UTSM-proto/utsm-telem-firmware/lte_relay/README.md

# QUICK START: LIVE TELEMETRY

From the `utsm-telem-firmware` repository folder, run this one command:

```powershell
.\start_live_telem.cmd
```

The setup page opens automatically. Connect only the WROVER by USB, select its
COM port, and click **Program WROVER and start telemetry**. The launcher handles
the dashboard, permanent Cloudflare route, private key, firmware build, upload,
and redirect to the live telemetry page. Running the command again
automatically replaces the previous idle UTSM dashboard process.

The public dashboard is `https://telem.utsm.party/live`. The Cloudflared
Windows service starts at boot with the same hostname. The dashboard also has
an at-sign-in startup task, so restarting the computer or externally powered
WROVER does not change the firmware endpoint and does not require reflashing.

# T-A7670X LTE relay

This sketch receives the existing telemetry record over ESP-NOW and posts it
to the software dashboard over LTE. SD logging on the ESP32-C3 remains the
complete source of truth; this relay intentionally has no persistent buffer.

The same WROVER also accepts the dyno joulemeter C3's distinct ESP-NOW packet
on channel 1. It maintains one newest-packet slot per source and alternates
between ready car and dyno data, so a slow LTE POST cannot make one sender
overwrite the other sender's newest measurement.

## Hardware

- LILYGO T-A7670E/G/SA ESP32-WROVER-E board
- ESP32-C3 SuperMini on the TelemV2 telemetry board
- second ESP32-C3 SuperMini running the dyno joulemeter firmware
- LTE main antenna attached before powering the modem
- Activated nano-SIM with data service
- Stable USB/5 V supply capable of modem current peaks (use at least 2 A)

The ESP-NOW hop is wireless. Do not connect UART wires between the logger and
relay. Power both boards normally and keep them within radio range.

### Dyno integration flash order

1. Deploy the matching telemetry dashboard change.
2. Copy `relay_config.example.h` to the ignored `relay_config.h`, keep the
   existing API key private, and set the dashboard `/api/live/telemetry` URL.
3. Flash `lte_relay.ino` to the WROVER/A7670 first. This reflash is required
   because the relay must recognize the new dyno packet type.
4. Keep the existing live-car C3 firmware running; it does not need a reflash
   for this change.
5. Flash `dyno_joulemeter_firmware.ino` from `UTSM-proto/proto-dyno` to the
   second C3.
6. Open the site, click **Start dyno test**, run the dyno, then click **Stop
   test** to freeze the Wh-to-Wh efficiency result.

Expected relay lines while both sources are active:

```text
Dashboard POST status=202
LIVE seq=12 delivered in ... ms json=... B
DYNO seq=18 delivered in ... ms P=84.215 W json=... B
```

Successful compilation does not validate ESP-NOW range, sensor calibration,
LTE timing, or simultaneous delivery on physical hardware.

The root preparation script now includes the dyno checkout and opens all three
Arduino sketches while retaining the existing dashboard, API-key, and
Cloudflare-tunnel setup:

```powershell
powershell -ExecutionPolicy Bypass -File .\prepare_live_motor_temp.ps1
```

For the single-entry setup portal, run this instead:

```powershell
.\start_live_telem.cmd
```

The command opens `http://127.0.0.1:8000/setup`. Connect only the WROVER,
select its COM port, and click **Program WROVER and start telemetry**. The page
creates or validates the Cloudflare tunnel, writes the matching private API key
and tunnel endpoint into the ignored relay configuration, compiles with the
Huge APP and PSRAM settings, uploads the relay, and redirects to `/live` after
a successful flash. The programming controls accept requests only through the
local `localhost` page; they are not available through the public tunnel.

When testing from alternate Git worktrees, pass their paths without moving or
stashing another checkout's changes:

```powershell
powershell -ExecutionPolicy Bypass -File .\prepare_live_motor_temp.ps1 `
  -SoftwareRepoPath "C:\path\to\telemetry-site-worktree" `
  -DynoRepoPath "C:\path\to\proto-dyno-worktree"
```

### Verified bench configuration

The complete path was bench-tested with:

- LILYGO T-A7670G R2 with `A7670G-LLSE` modem
- A7670 firmware `A7670M7_B02V01_251111`
- Lucky Mobile SIM
- Lucky Mobile APN `connect`, with blank username and password
- ESP32-C3 SuperMini transmitting ESP-NOW broadcast packets on channel 1
- FastAPI dashboard exposed temporarily through Cloudflare Tunnel

The modem registered on LTE, opened a packet-data session, received an IP,
and delivered matching C3 packet sequences to the dashboard.

### Physical setup

1. With power disconnected, attach the LTE antenna to the connector marked
   `SIM`/`LTE`; do not attach it to `GNSS` for the LTE test.
2. Disable the SIM PIN in a phone, power the board off, and insert the nano-SIM.
3. Power the A7670X through its USB-C port using a data-capable USB-A-to-USB-C
   cable and a source capable of 5 V/2 A peaks. This board can fail to power
   from USB-C-to-USB-C.
4. Power the C3 separately. No UART wiring is required between the boards.
5. Keep the two boards within a few metres for the bench test.

## Modem communication smoke test

Before installing LTE libraries or inserting a SIM, flash
`a7670_at_test/a7670_at_test.ino`. Open Serial Monitor at 115200 baud. The
automatic test should return `OK` for `AT` and print the exact modem identity
for `AT+SIMCOMATI`. The monitor then remains as a direct AT-command terminal.

## Arduino setup

Install:

- Espressif `esp32` board package
- LilyGO's bundled `TinyGSM` fork from the `lib` folder in
  [LilyGo-Modem-Series](https://github.com/Xinyuan-LilyGO/LilyGo-Modem-Series)

Select an ESP32 WROVER-compatible board and enable PSRAM if that board profile
offers the option.

Tested A7670X Arduino IDE settings:

- Board: `ESP32 Dev Module`
- CPU frequency: `240 MHz (WiFi/BT)`
- Flash frequency: `80 MHz`
- Flash mode: `QIO`
- Flash size: `4 MB`
- Partition scheme: `Huge APP (3MB No OTA/1MB SPIFFS)`
- PSRAM: enabled
- Serial Monitor: `115200` baud

For the C3 dummy sender, select `ESP32C3 Dev Module` and use a 115200-baud
Serial Monitor.

Copy `relay_config.example.h` to `relay_config.h`, then set the carrier APN,
the full dashboard ingestion URL, and the same API key used by the server.

Example Lucky Mobile configuration:

```cpp
static const char LTE_APN[] = "connect";
static const char LTE_USER[] = "";
static const char LTE_PASSWORD[] = "";
static const char SIM_PIN[] = "";
static const char TELEMETRY_ENDPOINT[] =
  "https://YOUR-TUNNEL.trycloudflare.com/api/live/telemetry";
static const char TELEMETRY_API_KEY[] = "replace-with-demo-key";
static const char TELEMETRY_DEVICE_ID[] = "utsm-a7670g";
```

For a first SIM test, disable the SIM PIN in a phone, confirm mobile data works,
then move the powered-off SIM into the T-A7670X. A normal phone SIM usually
works when the carrier permits modem/tethered data and the APN is correct.

## Start the dashboard and tunnel

From the software repository in PowerShell:

```powershell
python -m venv .venv
.venv\Scripts\Activate.ps1
python -m pip install -r requirements.txt
$env:UTSM_TELEMETRY_API_KEY = "replace-with-demo-key"
python -m uvicorn live_dashboard.app:app --host 0.0.0.0 --port 8000
```

Open `http://127.0.0.1:8000/live`. In a second PowerShell window:

```powershell
cloudflared tunnel --url http://localhost:8000
```

Put the generated HTTPS hostname plus `/api/live/telemetry` in
`TELEMETRY_ENDPOINT`. The API key must exactly match the environment variable.
Quick-tunnel hostnames change whenever the tunnel is restarted. The normal
UTSM workflow now uses the permanent `telem.utsm.party` tunnel instead.

## Prototype behavior

- Valid records are posted immediately.
- Records received while LTE is unavailable are dropped from the live stream.
- The original ESP32-C3 SD CSV is unaffected.
- The logger broadcasts at most once per second. If LTE is slower than the
  incoming stream, the relay keeps only the newest pending packet so the live
  page catches up instead of displaying an old FIFO backlog.
- The WROVER prints each LTE POST duration and JSON payload size. Use those
  values to measure the carrier/modem's real sustainable rate and watch data
  use against the vehicle SIM's 500 MB allowance; HTTP/TLS overhead is not
  included in the printed JSON byte count.
- SD still records at the full sensor sample rate. The TelemV2 logger uses the
  ADS1115's 860 SPS conversion mode while retaining 20-sample averaging and a
  separate open/write/close for every SD row.
- TelemV2 sends valid GPS latitude/longitude with the live packet. The map
  activates automatically after the GPS obtains a fix.
- TelemV2 sends beam-break `wheel_speed_kph` and its validity state. A valid
  stopped wheel is sent as `0.00`; an uninitialized sensor is sent as `null`.

## Level 2: LTE-only dummy test

This test uses only the T-A7670X and verifies SIM registration, LTE data,
HTTPS ingestion, WebSocket updates, gauges, charts, table, and map. The main
ESP32-C3 telemetry board is not required.

1. Copy `relay_config.example.h` to `relay_config.h`.
2. Set the carrier APN, public dashboard endpoint, and matching API key.
3. Set `LTE_DUMMY_TEST_MODE = true`.
4. Flash `lte_relay.ino` and open the serial monitor at 115200 baud.
5. Expect `Mode: LEVEL 2 LTE DUMMY TEST`, an assigned LTE IP, HTTP status 202,
   repeating `DUMMY seq=N delivered` messages, and changing speed on the live
   dashboard.
6. Return `LTE_DUMMY_TEST_MODE` to `false` before the ESP-NOW integration test.

## Level 3: full-path ESP-NOW dummy test

This proves `ESP32-C3 telemetry board -> ESP-NOW -> A7670X relay -> LTE -> dashboard`
without requiring live sensors.

1. Set `LTE_DUMMY_TEST_MODE = false` in the relay's ignored `relay_config.h`.
2. Flash `lte_relay/lte_relay.ino` to the T-A7670X and leave it powered.
3. Flash `telem-v1/espnow_dummy_sender/espnow_dummy_sender.ino` to the ESP32-C3
   SuperMini.
4. Open both serial monitors at 115200 if two USB ports are available.
5. The C3 prints `C3 ESP-NOW queued seq=N`; the relay prints
   `LIVE seq=N delivered`; the dashboard updates with the same sequence.

Expected relay output:

```text
Mode: LIVE ESP-NOW RELAY
Relay ESP-NOW channel: 1
LTE connected; IP: ...
Dashboard POST status=202
LIVE seq=0 delivered
```

Expected C3 output:

```text
C3 ESP-NOW channel: 1
C3 dummy sender ready; transmitting every 2 seconds
C3 ESP-NOW queued seq=0 I=11000 mA V=49560 mV
```

Both boards are explicitly pinned to ESP-NOW channel 1 for this demo.

### If the relay prints status 715

`Dashboard POST status=715` is an A7670 TLS-handshake failure. It is not, by
itself, evidence that the SIM is out of data. If the preceding lines show LTE
registration, a normal CSQ value, and an assigned IP address, the packet-data
session is up. Check whether the tunnel's current TLS certificate and cipher
support are compatible with the modem firmware. A successful vehicle-path test
still requires status 202, `LIVE seq=... delivered`, and a fresh dashboard row.

## Level 4: TelemV2 live vehicle demo

This is the real end-to-end path:
`TelemV2 -> ESP-NOW -> WROVER/A7670 -> LTE -> HTTPS -> live dashboard`.

On the UTSM Windows workstation, the root-level preparation script automates
the local setup: Arduino dependencies, LilyGO's A7670-compatible TinyGSM fork,
dashboard startup, Cloudflare quick tunnel, ignored relay endpoint update, and
opening both Arduino sketches. Run it from PowerShell:

```powershell
powershell -ExecutionPolicy Bypass -File .\prepare_live_motor_temp.ps1
```

After it reports `PREPARATION COMPLETE`, the only manual operations are the two
Arduino IDE uploads: flash `lte_relay.ino` to the WROVER/A7670 first, then flash
`telemetry_v2.ino` to the ESP32-C3. The script never prints the telemetry API
key. Re-running it reuses a healthy tunnel and existing configured credentials.

1. Start the dashboard with `UTSM_TELEMETRY_API_KEY` set and open `/live`.
2. Start a Cloudflare quick tunnel and copy its current HTTPS hostname.
3. In the ignored `relay_config.h`, set `TELEMETRY_ENDPOINT` to that hostname
   followed by `/api/live/telemetry`, use the same API key as the server, and
   ensure `LTE_DUMMY_TEST_MODE = false`.
4. Flash `lte_relay/lte_relay.ino` to the WROVER/A7670 board.
5. Flash `telem-v2/telemetry_v2/telemetry_v2.ino` to the ESP32-C3 logger.
6. Attach the LTE and GPS antennas, insert the SIM, power both boards, and
   leave the laptop running the dashboard and tunnel.
7. Wait through TelemV2 initialization. Its LED becomes solid when SD logging
   starts. Outdoors, wait for the live page map to receive a GPS position.
8. The page targets a new row about once per second. Actual rate is capped by
   the measured LTE POST duration printed by the relay. Move the car outdoors
   and the GPS marker/trail should move with the vehicle.

The relay's serial success line is `LIVE seq=N delivered`, but serial access is
not required in the vehicle: increasing sequence numbers on `/live` prove the
complete path. If rows update without a map marker, LTE is working but the GPS
does not yet have a valid fix.

When only the WROVER Serial Monitor is accessible, each real packet also shows:

```text
GPS seq=12 rx=GPIO20 baud=9600 bytes=1842 nmea=yes sats=7 utc=yes fix=yes
```

- `bytes=0`: the C3 has received no electrical UART data at the displayed pin/rate.
- Increasing `bytes` with `nmea=no`: bytes exist, but no checksum-valid NMEA sentence has been decoded yet.
- `rx=GPIO21` or `rx=GPIO20` and `baud=...`: the candidate currently being tested or locked.
- `nmea=yes sats=0`: the module is communicating but has not acquired satellites.
- `sats>0 fix=no`: keep the antenna stationary with a clear view of the sky.
- `fix=yes`: the next LTE post includes latitude/longitude for the live map.

If the C3 prints `queued` but the relay prints nothing, confirm both serial
monitors report ESP-NOW channel 1. If the relay reports HTTP 401, the dashboard
and relay API keys differ. HTTP 404 usually means the endpoint is missing
`/api/live/telemetry`.
