UTSM-proto/utsm-telem-firmware/telem-v2/pcb/telem-v2-pcb/joulemeter.kicad_pcb

## KiCad design telem-v2/pcb/telem-v2-pcb/joulemeter.kicad_pcb (2026-07-04)

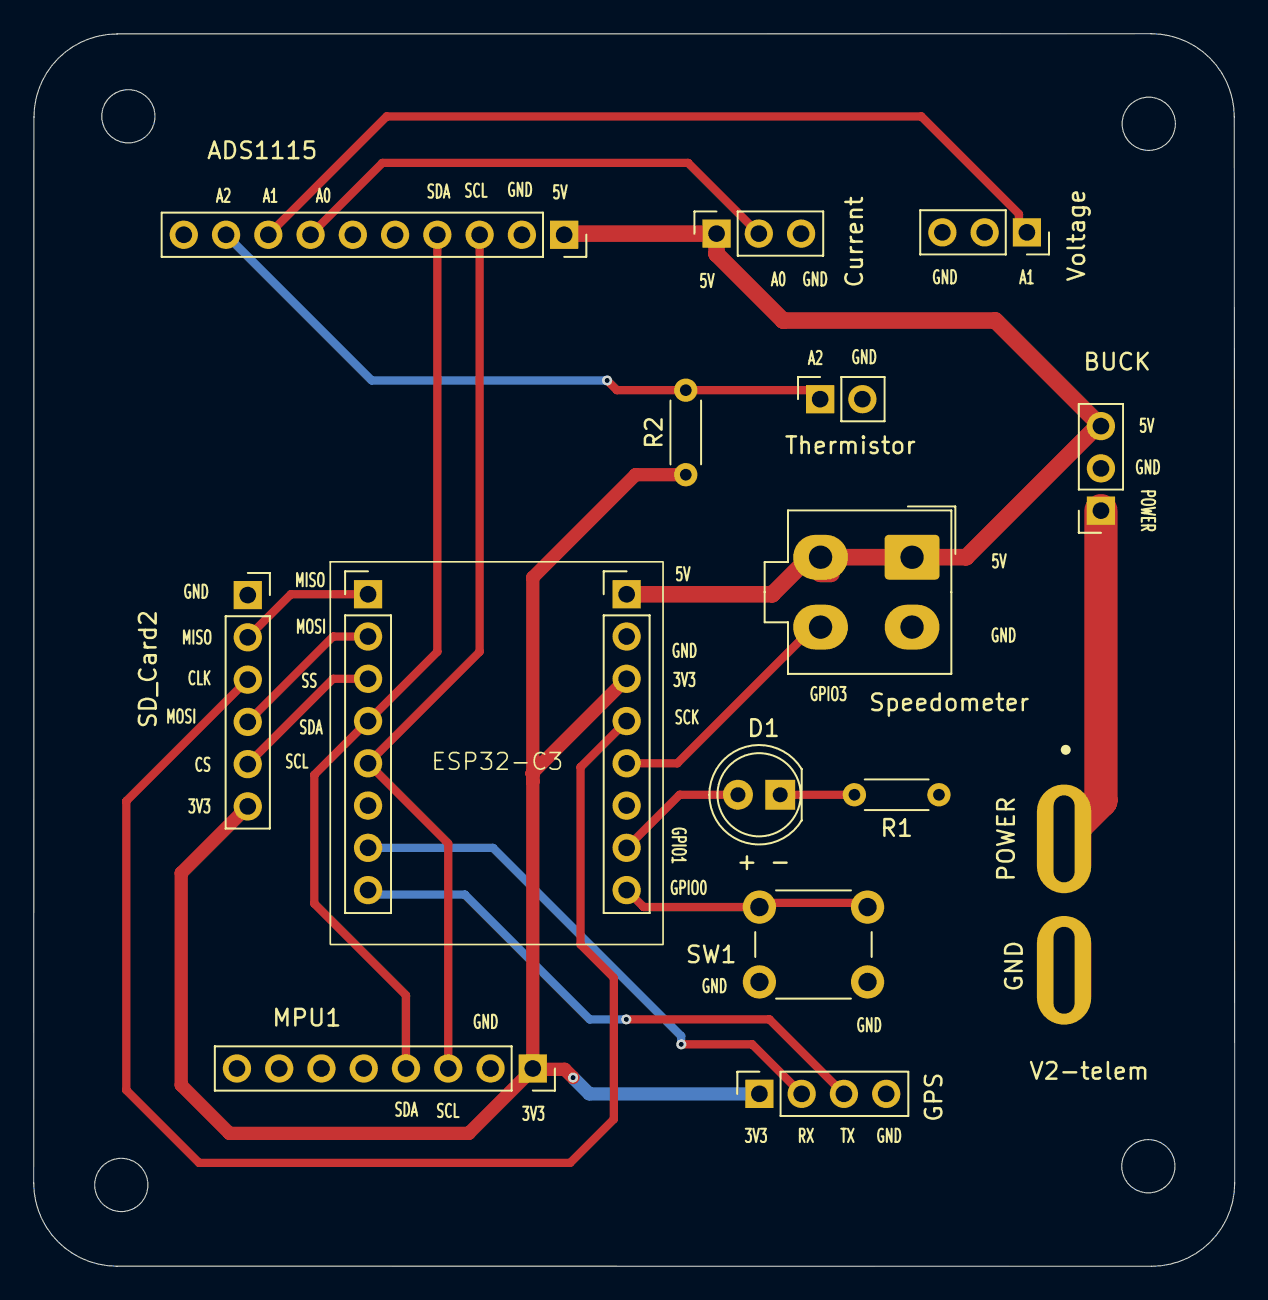
[picture p1: board telem-v2/pcb/telem-v2-pcb/joulemeter.kicad_pcb from above]

Board: 2 copper layers, 72.2 x 74.1 mm, 15 parts (0 on the bottom side), 19 nets.

Parts:
ADS1115: Conn_01x10_Pin; PinSocket_1x10_P2.54mm_Vertical
BuckConverter1: Conn_01x03_Pin; PinSocket_1x03_P2.54mm_Vertical
Current: Conn_01x03_Pin; PinSocket_1x03_P2.54mm_Vertical
D1: LED; LED_D5.0mm
ESP32-C3: C3; ESP32C3
GPS: Conn_01x04_Pin; PinSocket_1x04_P2.54mm_Vertical
J1: ASMPR45-1X2-RK; APP_ASMPR45-1X2-RK
J2: Speedometer; Molex_Mini-Fit_Jr_5566-04A_2x02_P4.20mm_Vertical
MPU1: Conn_01x8_Pin; PinSocket_1x08_P2.54mm_Vertical
R1: R; R_Axial_DIN0204_L3.6mm_D1.6mm_P5.08mm_Horizontal
R2: 33k; R_Axial_DIN0204_L3.6mm_D1.6mm_P5.08mm_Horizontal
SD_Card2: Conn_01x6_Pin; PinSocket_1x06_P2.54mm_Vertical
SW1: SW_Push; SW_PUSH_6mm_H5mm
TH1: Thermistor; PinSocket_1x02_P2.54mm_Vertical
Voltage: Conn_01x03_Pin; PinSocket_1x03_P2.54mm_Vertical

Connections:
3.3V: ESP32-C3.13 (3.3V), GPS.1 (VCC), MPU1.1 (VCC), R2.1, SD_Card2.6 (3.3V)
+5V: ADS1115.1 (VDD), BuckConverter1.3 (VCC), Current.1 (VCC), ESP32-C3.11 (5V), J2.1, J2.3
External_Power: BuckConverter1.1 (External_Power), J1.1
GND: ADS1115.2 (GND), BuckConverter1.2 (GND), Current.3 (GND), ESP32-C3.12 (GND), GPS.4 (GND), J1.2, J2.2, MPU1.2 (GND), R1.2, SD_Card2.1 (GND), SW1.2, TH1.2, Voltage.3 (-)
MISO: ESP32-C3.5 (5-MISO), SD_Card2.2 (MISO)
MOSI: ESP32-C3.6 (6-MOSI), SD_Card2.4 (MOSI)
unnamed: ADS1115.7 (A0), Current.2 (OUT)
unnamed: ADS1115.8 (A1), Voltage.1 (S)
unnamed: ADS1115.9 (A2), R2.2, TH1.1
unnamed: D1.2 (A), ESP32-C3.1 (GPIO1)
unnamed: D1.1 (K), R1.1
unnamed: ESP32-C3.7 (7-SS), SD_Card2.5 (CS)
unnamed: ESP32-C3.0 (GPIO0), SW1.1
unnamed: ESP32-C3.3 (GPIO3), J2.4
RX: ESP32-C3.20 (20-RX), GPS.2 (RX)
SCK: ESP32-C3.4 (GPIO4-SCK), SD_Card2.3 (CLK)
SCL: ADS1115.3 (SCL), ESP32-C3.9 (9-SCL), MPU1.3 (SCL)
SDA: ADS1115.4 (SDA), ESP32-C3.8 (8-SDA), MPU1.4 (SDA)
TX: ESP32-C3.21 (21-TX), GPS.3 (TX)
