UTSM-proto/utsm-telem-firmware/telem-v1/pcb/telem-v1-pcb/joulemeter.kicad_pcb

## KiCad design telem-v1/pcb/telem-v1-pcb/joulemeter.kicad_pcb (2026-06-18, an earlier design)

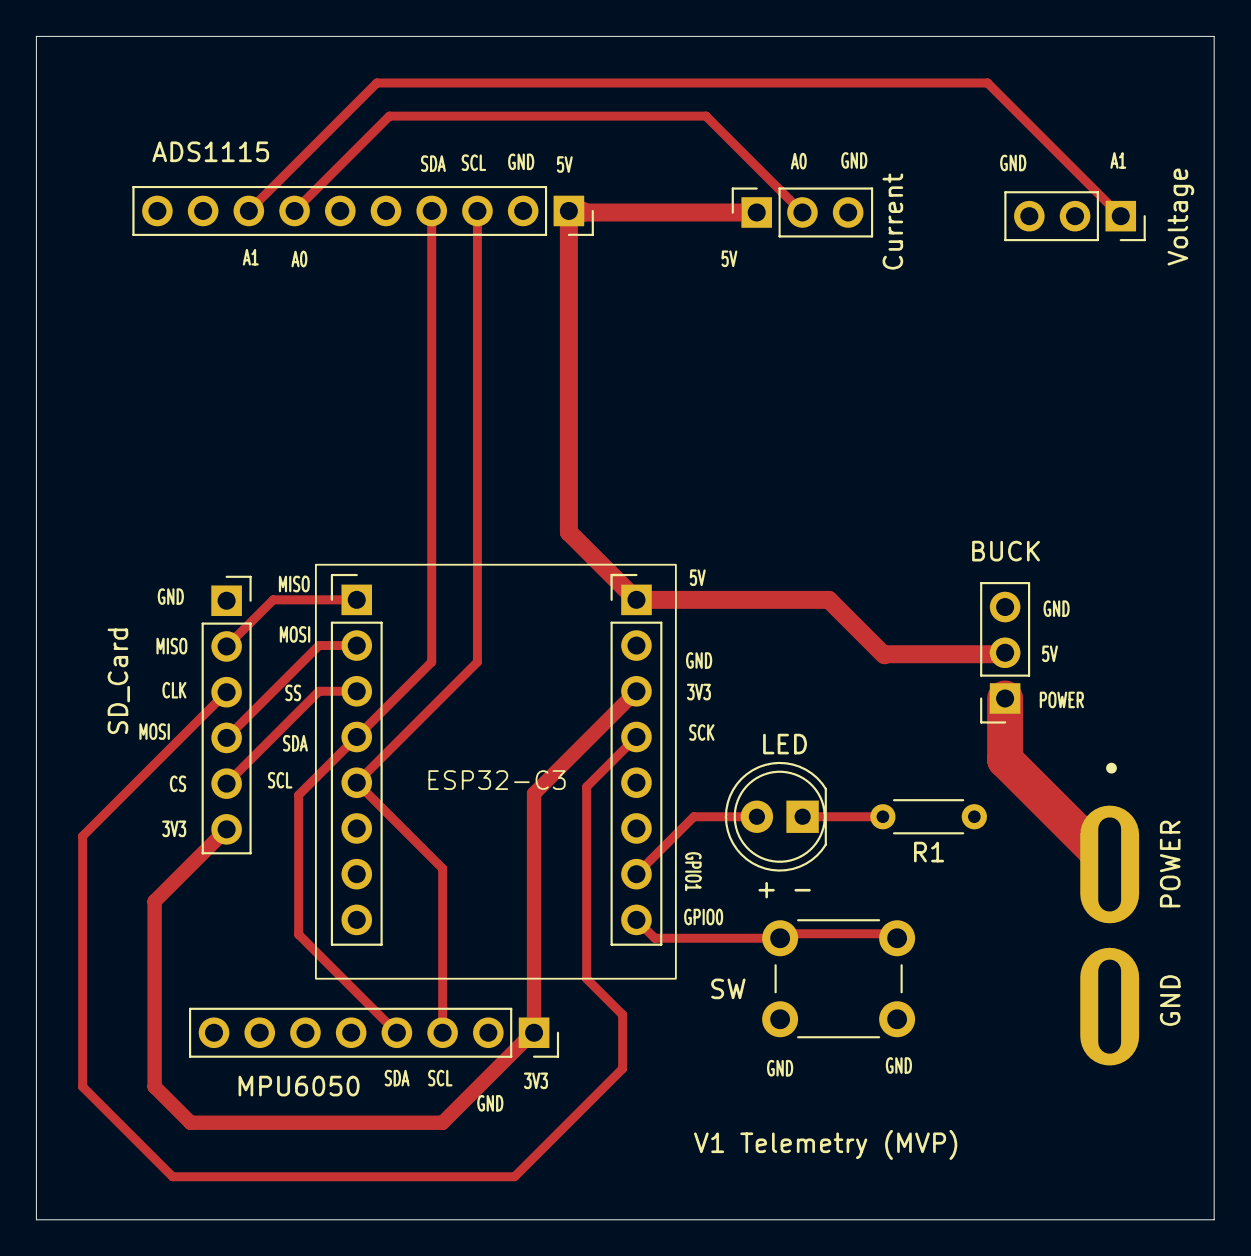
[picture p2: board telem-v1/pcb/telem-v1-pcb/joulemeter.kicad_pcb from above]

Board: 2 copper layers, 65.4 x 65.7 mm, 11 parts (0 on the bottom side), 15 nets.

Parts:
ADS1115: Conn_01x10_Pin; PinSocket_1x10_P2.54mm_Vertical
BuckConverter: Conn_01x03_Pin; PinSocket_1x03_P2.54mm_Vertical
Current: Conn_01x03_Pin; PinSocket_1x03_P2.54mm_Vertical
ESP32-C3: C3; ESP32C3
J1: ASMPR45-1X2-RK; APP_ASMPR45-1X2-RK
LED: LED; LED_D5.0mm
MPU6050: Conn_01x8_Pin; PinSocket_1x08_P2.54mm_Vertical
R1: R; R_Axial_DIN0204_L3.6mm_D1.6mm_P5.08mm_Horizontal
SD_Card: Conn_01x6_Pin; PinSocket_1x06_P2.54mm_Vertical
SW: SW_Push; SW_PUSH_6mm_H5mm
Voltage: Conn_01x03_Pin; PinSocket_1x03_P2.54mm_Vertical

Connections:
3.3V: ESP32-C3.13 (3.3V), MPU6050.1 (VCC), SD_Card.6 (3.3V)
+5V: ADS1115.1 (VDD), BuckConverter.2 (VCC), Current.1 (VCC), ESP32-C3.11 (5V)
External_Power: BuckConverter.1 (External_Power), J1.1
GND: ADS1115.2 (GND), BuckConverter.3 (GND), Current.3 (GND), ESP32-C3.12 (GND), J1.2, MPU6050.2 (GND), R1.2, SD_Card.1 (GND), SW.2, Voltage.3 (-)
MISO: ESP32-C3.5 (5-MISO), SD_Card.2 (MISO)
MOSI: ESP32-C3.6 (6-MOSI), SD_Card.4 (MOSI)
unnamed: ADS1115.7 (A0), Current.2 (OUT)
unnamed: ADS1115.8 (A1), Voltage.1 (S)
unnamed: ESP32-C3.1 (GPIO1), LED.2 (A)
unnamed: LED.1 (K), R1.1
unnamed: ESP32-C3.7 (7-SS), SD_Card.5 (CS)
unnamed: ESP32-C3.0 (GPIO0), SW.1
SCK: ESP32-C3.4 (GPIO4-SCK), SD_Card.3 (CLK)
SCL: ADS1115.3 (SCL), ESP32-C3.9 (9-SCL), MPU6050.3 (SCL)
SDA: ADS1115.4 (SDA), ESP32-C3.8 (8-SDA), MPU6050.4 (SDA)
