UTSM-proto/utsm-telem-firmware/telem-v2/telemetry_v2/telemetry_v2.ino

/*
  ESP32-C3 Vehicle Telemetry Logger
  ---------------------------------
  Arduino setup/dependencies:
    - Board target: ESP32C3 Dev Module (esp32:esp32:esp32c3)
    - Install "esp32 by Espressif Systems" in Boards Manager
    - Install "TinyGPSPlus by Mikal Hart" in Library Manager
    - Wire, LittleFS, FS, SD, and SPI are included with the ESP32 board core
    - WiFi and ESP-NOW are included with the ESP32 board core

  Collects:
    - Current from ADS1115 AIN0
    - Voltage from ADS1115 AIN1
    - Thermistor temperature from ADS1115 AIN2
    - Acceleration from MPU6050
    - Wheel speed from a beam-break sensor and 12 wheel spokes
    - GPS position, speed, altitude, HDOP, satellites, and UTC time
  Writes each recording session to an SD-card CSV.
  Mirrors current, voltage, acceleration, and GPS every 1 second over ESP-NOW
  to the vehicle's WROVER/A7670 LTE relay. Live forwarding never blocks SD.

  CSV filenames are derived directly from GPS UTC time:
      /YYYY-MM-DD-HH-MM.csv
  If that name already exists:
      /YYYY-MM-DD-HH-MM-001.csv
  If GPS time is unavailable after the startup wait:
      /telemetry_001.csv

  Status LED:
    - Repeating flashes with a long pause indicate a fatal fault. Count the
      flashes and see telem-v2/telemetry_v2/README.md.
    - Solid ON means recording. OFF means manually stopped.

  Pin mapping (ESP32-C3 Super Mini):
    I2C SDA       GPIO8
    I2C SCL       GPIO9
    Start/stop    GPIO0, active LOW
    Status LED    GPIO1
    Speedometer   GPIO3 (LM393 digital output)
    SD SCK        GPIO4
    SD MISO       GPIO5
    SD MOSI       GPIO6
    SD CS         GPIO7
    GPS RX        GPIO20 (connected to GPS module TX)
    GPS TX        unused (GPS module RX is connected to GPIO21)
*/

#include <Arduino.h>
#include <Wire.h>
#include <LittleFS.h>
#include <math.h>
#include <TinyGPS++.h>

#include "FS.h"
#include "SD.h"
#include "SPI.h"
#include "live_telemetry_espnow.h"

// =========================
// Pin mapping
// =========================
static const int PIN_I2C_SDA = 8;
static const int PIN_I2C_SCL = 9;
static const int BUTTON_PIN  = 0;
static const int LED_PIN     = 1;
static const int SPEED_SENSOR_PIN = 3;

static const int SD_CS   = 7;
static const int SD_MOSI = 6;
static const int SD_MISO = 5;
static const int SD_SCK  = 4;

// Confirmed vehicle wiring: GPS module TX is connected to C3 GPIO20 and GPS
// module RX is connected to C3 GPIO21. The logger only receives, so GPIO20 is
// the primary UART RX candidate and GPIO21 is retained as a diagnostic fallback.
static const int GPS_PRIMARY_RX_PIN = 20;
static const int GPS_ALTERNATE_RX_PIN = 21;
static const uint32_t GPS_BAUD = 9600;
static const uint32_t GPS_UART_PROBE_MS = 3000;

// The logger never sends configuration commands to the GPS, so UART TX is
// intentionally left disconnected. This lets detection listen on either PCB
// trace without ever driving against the GPS module's TX output.
static const int GPS_UART_TX_UNUSED = -1;

struct GpsUartCandidate {
  int rxPin;
  uint32_t baud;
};

static const GpsUartCandidate GPS_UART_CANDIDATES[] = {
  {GPS_PRIMARY_RX_PIN, 9600},
  {GPS_ALTERNATE_RX_PIN, 9600},
  {GPS_PRIMARY_RX_PIN, 38400},
  {GPS_ALTERNATE_RX_PIN, 38400},
  {GPS_PRIMARY_RX_PIN, 115200},
  {GPS_ALTERNATE_RX_PIN, 115200},
  {GPS_PRIMARY_RX_PIN, 4800},
  {GPS_ALTERNATE_RX_PIN, 4800},
};
static const size_t GPS_UART_CANDIDATE_COUNT =
  sizeof(GPS_UART_CANDIDATES) / sizeof(GPS_UART_CANDIDATES[0]);

// =========================
// Beam-break speedometer
// =========================
// The LM393 output is LOW while a spoke blocks the beam and HIGH while the
// beam is clear. A small high-priority task debounces both states and counts
// exactly one completed blocked-to-clear cycle per spoke. This prevents
// comparator flicker at either spoke border from becoming extra wheel pulses.
// The module used by the dyno has its own output pull-up, so GPIO3 is a plain
// input.
static const uint8_t WHEEL_SPOKES = 12;
static const float WHEEL_DIAMETER_M = 20.0f * 0.0254f;
static const float WHEEL_CIRCUMFERENCE_M = PI * WHEEL_DIAMETER_M;
static const uint32_t SPEED_SAMPLE_PERIOD_MS = 1;
static const uint32_t SPEED_STATE_DEBOUNCE_US = 2000;
// Real spoke events are about 12 ms apart at the vehicle's 40 km/h maximum.
// An 8 ms guard rejects impossible repeats while retaining margin to 60 km/h.
static const uint32_t SPEED_MIN_PULSE_INTERVAL_US = 8000;
static const uint32_t SPEED_STOP_TIMEOUT_US = 2000000;

portMUX_TYPE g_speedMux = portMUX_INITIALIZER_UNLOCKED;
volatile bool g_speedHasPulse = false;
volatile uint32_t g_speedLastPulseUs = 0;
volatile uint32_t g_speedIntervalSumUs = 0;
volatile uint16_t g_speedIntervalCount = 0;
volatile uint32_t g_speedSpokeCount = 0;

bool g_wheelSpeedValid = false;
float g_wheelSpeedKmph = 0.0f;
float g_wheelRpm = 0.0f;
uint32_t g_wheelSpokeCount = 0;

// =========================
// Device addresses
// =========================
static const uint8_t ADS1115_ADDR = 0x48;
static const uint8_t MPU6050_ADDR = 0x68;

// =========================
// Sampling constants
// =========================
#define CURRENT_NUM_SAMPLES  20

#define MPU_NUM_SAMPLES      20
#define MPU_SAMPLE_DELAY     3

// GPS is serviced during all long waits so its UART buffer does not overflow.
static const uint32_t GPS_FILENAME_WAIT_MS = 30000;
static const uint32_t GPS_DIAGNOSTIC_INTERVAL_MS = 1000;

// =========================
// ADS1115 registers/config
// =========================
#define ADS1115_REG_CONVERSION      0x00
#define ADS1115_REG_CONFIG          0x01

#define ADS1115_CONFIG_OS_SINGLE    0x8000
#define ADS1115_CONFIG_MUX_AIN0_GND 0x4000
#define ADS1115_CONFIG_MUX_AIN1_GND 0x5000
#define ADS1115_CONFIG_MUX_AIN2_GND 0x6000
#define ADS1115_CONFIG_PGA_4V096    0x0200
#define ADS1115_CONFIG_MODE_SINGLE  0x0100
#define ADS1115_CONFIG_DR_860SPS    0x00E0
#define ADS1115_CONFIG_COMP_DISABLE 0x0003

// At 860 samples/second a single conversion takes about 1.2 ms. Waiting 2 ms
// retains margin without the old fixed 10 ms delay on every channel read.
static const uint32_t ADS1115_CONVERSION_WAIT_MS = 2;

#define ADS1115_CONFIG_WORD_AIN0 (ADS1115_CONFIG_OS_SINGLE     | \
                                  ADS1115_CONFIG_MUX_AIN0_GND  | \
                                  ADS1115_CONFIG_PGA_4V096     | \
                                  ADS1115_CONFIG_MODE_SINGLE   | \
                                  ADS1115_CONFIG_DR_860SPS     | \
                                  ADS1115_CONFIG_COMP_DISABLE)

#define ADS1115_CONFIG_WORD_AIN1 (ADS1115_CONFIG_OS_SINGLE     | \
                                  ADS1115_CONFIG_MUX_AIN1_GND  | \
                                  ADS1115_CONFIG_PGA_4V096     | \
                                  ADS1115_CONFIG_MODE_SINGLE   | \
                                  ADS1115_CONFIG_DR_860SPS     | \
                                  ADS1115_CONFIG_COMP_DISABLE)

#define ADS1115_CONFIG_WORD_AIN2 (ADS1115_CONFIG_OS_SINGLE     | \
                                  ADS1115_CONFIG_MUX_AIN2_GND  | \
                                  ADS1115_CONFIG_PGA_4V096     | \
                                  ADS1115_CONFIG_MODE_SINGLE   | \
                                  ADS1115_CONFIG_DR_860SPS     | \
                                  ADS1115_CONFIG_COMP_DISABLE)

static const float ADS1115_LSB_VOLTS = 4.096f / 32768.0f;

// =========================
// Current/voltage calibration
// =========================
static const float ADC_DIVIDER_RATIO   = 1.0f;
static const float ADC_ZERO_CURRENT_V  = 2.55f;
static const float ADC_SENSITIVITY     = 0.066f;
static const float VOLTAGE_INPUT_SCALE = 5.93f;
// Bench fit: I_actual = 0.7949 * I_measured - 0.70904 A.
// Startup zeroing is performed after this fit so resting current remains 0 A.
static const float CURRENT_CAL_SLOPE     = 0.7949f;
static const float CURRENT_CAL_INTERCEPT = -0.70904f;

static const uint32_t CURRENT_ZERO_CAL_DELAY_MS = 15000;
static const uint32_t CURRENT_ZERO_CAL_TIME_MS  = 3000;
float g_currentOffsetA = 0.0f;

// =========================
// Thermistor calibration
// =========================
// Divider:
//   3.28 V -- 33.5k resistor -- AIN2 -- thermistor -- GND
static const float THERMISTOR_SUPPLY_V          = 3.28f;
static const float THERMISTOR_SERIES_R_OHMS     = 33500.0f;
static const float THERMISTOR_NOMINAL_R_OHMS    = 95000.0f;
static const float THERMISTOR_NOMINAL_TEMP_C    = 23.5f;
static const float THERMISTOR_B_COEFFICIENT     = 3950.0f;

// Ground AIN2 and use serial command 'c' to measure this offset.
// Copy the reported value here if a permanent correction is required.
static const float THERMISTOR_ADC_OFFSET_V = 0.0f;
float g_thermistorAdcOffsetV = THERMISTOR_ADC_OFFSET_V;
static const uint16_t THERMISTOR_OFFSET_CAL_SAMPLES = 64;

// =========================
// MPU6050 registers/config
// =========================
#define MPU6050_REG_PWR_MGMT_1   0x6B
#define MPU6050_REG_ACCEL_CONFIG 0x1C
#define MPU6050_REG_ACCEL_XOUT_H 0x3B

#define MPU6050_ACCEL_SENS_2G 16384.0f
#define GRAVITY_MPS2          9.80665f

// =========================
// GPS
// =========================
TinyGPSPlus gps;
HardwareSerial gpsSerial(1);
int g_gpsRxPin = GPS_PRIMARY_RX_PIN;
uint32_t g_gpsBaud = GPS_BAUD;
size_t g_gpsUartCandidateIndex = 0;
bool g_gpsUartLocked = false;
uint32_t g_gpsUartProbeStartMs = 0;
uint32_t g_gpsUartByteCount = 0;
uint32_t g_gpsUartProbeStartByteCount = 0;
uint32_t g_gpsUartProbeStartPassedChecksum = 0;

// =========================
// Logging state
// =========================
static const uint16_t SD_MAX_LOG_FILES = 999;
char g_sdLogFile[48] = "/telemetry_unknown.csv";
uint16_t g_sdLogIndex = 0;

bool g_sdReady = false;
bool g_loggingEnabled = false;
LiveTelemetryEspNowSender g_liveTelemetry;

// The record layout includes wheel-speed fields, so use a new backup filename
// instead of interpreting older binary records with the new structure.
static const char *LITTLEFS_LOG_FILE = "/telemetry_v2_speed.bin";

volatile bool buttonEvent = false;
uint32_t lastButtonHandledMs = 0;
uint32_t lastGpsDiagnosticMs = 0;

// =========================
// Logged record
// =========================
struct TelemetryRecord_t
{
  uint32_t timestamp_ms;

  int16_t current_mA;
  int32_t voltage_mV;

  int16_t temperature_c_x100;
  uint8_t temperature_valid;

  uint8_t wheel_speed_valid;
  uint32_t wheel_speed_kmph_x100;
  uint32_t wheel_rpm_x10;
  uint32_t wheel_spoke_count;

  int16_t accel_x_mps2_x100;
  int16_t accel_y_mps2_x100;
  int16_t accel_z_mps2_x100;
  uint16_t accel_mag_mps2_x100;

  uint8_t gps_location_valid;
  int32_t gps_lat_e7;
  int32_t gps_long_e7;
  int32_t gps_alt_cm;
  uint16_t gps_speed_kmph_x100;
  uint16_t gps_hdop_x100;
  uint8_t gps_sats;

  uint8_t gps_time_valid;
  uint8_t gps_hour;
  uint8_t gps_minute;
  uint8_t gps_second;
  uint8_t gps_centisecond;
} __attribute__((packed));

// =========================
// Forward declarations
// =========================
void serviceGps();
void updateWheelSpeed();
void updateLoggingLed();
bool selectNextSDLogFile();
void startLoggingNewFile(const char *reason);

// =========================
// Interrupt
// =========================
void IRAM_ATTR buttonISR()
{
  buttonEvent = true;
}

void acceptSpeedPulse(uint32_t nowUs)
{
  portENTER_CRITICAL(&g_speedMux);

  if (!g_speedHasPulse) {
    g_speedHasPulse = true;
    g_speedLastPulseUs = nowUs;
    g_speedSpokeCount = g_speedSpokeCount + 1;
    portEXIT_CRITICAL(&g_speedMux);
    return;
  }

  uint32_t intervalUs = nowUs - g_speedLastPulseUs;

  // Reject repeats that imply a speed above the 60 km/h measurement margin.
  // Rejected events do not move the reference timestamp.
  if (intervalUs < SPEED_MIN_PULSE_INTERVAL_US) {
    portEXIT_CRITICAL(&g_speedMux);
    return;
  }

  g_speedLastPulseUs = nowUs;
  g_speedSpokeCount = g_speedSpokeCount + 1;

  // Do not turn a long stopped period into one misleading low-speed sample.
  // The next spoke interval will establish the restarted wheel speed.
  if (intervalUs >= SPEED_STOP_TIMEOUT_US) {
    portEXIT_CRITICAL(&g_speedMux);
    return;
  }

  if (UINT32_MAX - g_speedIntervalSumUs < intervalUs ||
      g_speedIntervalCount == UINT16_MAX) {
    g_speedIntervalSumUs = intervalUs;
    g_speedIntervalCount = 1;
  } else {
    g_speedIntervalSumUs += intervalUs;
    g_speedIntervalCount = g_speedIntervalCount + 1;
  }

  portEXIT_CRITICAL(&g_speedMux);
}

void speedSensorTask(void *parameter)
{
  (void)parameter;

  bool candidateClear = digitalRead(SPEED_SENSOR_PIN) == HIGH;
  bool stableClear = candidateClear;
  bool stableStateKnown = false;
  bool blockedCycleArmed = false;
  uint32_t candidateSinceUs = micros();

  for (;;) {
    uint32_t nowUs = micros();
    bool sampleClear = digitalRead(SPEED_SENSOR_PIN) == HIGH;

    if (sampleClear != candidateClear) {
      candidateClear = sampleClear;
      candidateSinceUs = nowUs;
    } else if ((uint32_t)(nowUs - candidateSinceUs) >=
               SPEED_STATE_DEBOUNCE_US) {
      if (!stableStateKnown) {
        stableStateKnown = true;
        stableClear = candidateClear;
        blockedCycleArmed = !stableClear;
      } else if (candidateClear != stableClear) {
        stableClear = candidateClear;

        if (!stableClear) {
          // A stable blocked state arms exactly one future clear event.
          blockedCycleArmed = true;
        } else if (blockedCycleArmed) {
          blockedCycleArmed = false;
          acceptSpeedPulse(nowUs);
        }
      }
    }

    vTaskDelay(pdMS_TO_TICKS(SPEED_SAMPLE_PERIOD_MS));
  }
}

void updateWheelSpeed()
{
  uint32_t intervalSumUs;
  uint16_t intervalCount;
  uint32_t lastPulseUs;
  uint32_t spokeCount;
  bool hasPulse;

  portENTER_CRITICAL(&g_speedMux);
  intervalSumUs = g_speedIntervalSumUs;
  intervalCount = g_speedIntervalCount;
  g_speedIntervalSumUs = 0;
  g_speedIntervalCount = 0;
  lastPulseUs = g_speedLastPulseUs;
  spokeCount = g_speedSpokeCount;
  hasPulse = g_speedHasPulse;
  portEXIT_CRITICAL(&g_speedMux);

  g_wheelSpokeCount = spokeCount;

  if (intervalCount > 0) {
    float averageIntervalUs =
      (float)intervalSumUs / (float)intervalCount;

    g_wheelRpm =
      60000000.0f / ((float)WHEEL_SPOKES * averageIntervalUs);
    g_wheelSpeedKmph =
      WHEEL_CIRCUMFERENCE_M * (g_wheelRpm / 60.0f) * 3.6f;
    g_wheelSpeedValid = true;
    return;
  }

  if (!hasPulse) {
    g_wheelSpeedValid = false;
    g_wheelSpeedKmph = 0.0f;
    g_wheelRpm = 0.0f;
    return;
  }

  if ((uint32_t)(micros() - lastPulseUs) >= SPEED_STOP_TIMEOUT_US) {
    g_wheelSpeedValid = true;
    g_wheelSpeedKmph = 0.0f;
    g_wheelRpm = 0.0f;
  }
}

// =========================
// GPS helpers
// =========================
void startGpsUartCandidate(size_t candidateIndex)
{
  const GpsUartCandidate &candidate = GPS_UART_CANDIDATES[candidateIndex];

  gpsSerial.end();
  delay(10);

  g_gpsRxPin = candidate.rxPin;
  g_gpsBaud = candidate.baud;
  gpsSerial.begin(
    g_gpsBaud,
    SERIAL_8N1,
    g_gpsRxPin,
    GPS_UART_TX_UNUSED
  );
  g_gpsUartProbeStartMs = millis();
  g_gpsUartProbeStartByteCount = g_gpsUartByteCount;
  g_gpsUartProbeStartPassedChecksum = gps.passedChecksum();

  Serial.printf(
    "GPS UART probe: RX GPIO%d at %lu baud.\n",
    g_gpsRxPin,
    (unsigned long)g_gpsBaud
  );
}

void serviceGps()
{
  while (gpsSerial.available() > 0) {
    ++g_gpsUartByteCount;
    gps.encode(gpsSerial.read());
  }

  if (g_gpsUartLocked) {
    return;
  }

  if (gps.passedChecksum() > g_gpsUartProbeStartPassedChecksum) {
    g_gpsUartLocked = true;
    Serial.printf(
      "GPS NMEA locked: RX GPIO%d at %lu baud, bytes=%lu.\n",
      g_gpsRxPin,
      (unsigned long)g_gpsBaud,
      (unsigned long)(g_gpsUartByteCount - g_gpsUartProbeStartByteCount)
    );
    return;
  }

  if ((uint32_t)(millis() - g_gpsUartProbeStartMs) >= GPS_UART_PROBE_MS) {
    Serial.printf(
      "No valid GPS NMEA on RX GPIO%d at %lu baud (raw bytes=%lu).\n",
      g_gpsRxPin,
      (unsigned long)g_gpsBaud,
      (unsigned long)(g_gpsUartByteCount - g_gpsUartProbeStartByteCount)
    );
    g_gpsUartCandidateIndex =
      (g_gpsUartCandidateIndex + 1) % GPS_UART_CANDIDATE_COUNT;
    startGpsUartCandidate(g_gpsUartCandidateIndex);
  }
}

bool gpsDateTimeValid()
{
  return gps.date.isValid() &&
         gps.time.isValid() &&
         gps.date.year() >= 2020;
}

void printGpsDiagnosticIfNeeded()
{
  uint32_t now = millis();

  if (now < 5000 || now - lastGpsDiagnosticMs < GPS_DIAGNOSTIC_INTERVAL_MS) {
    return;
  }

  lastGpsDiagnosticMs = now;

  if (!g_gpsUartLocked) {
    Serial.printf(
      "GPS SEARCH: RX GPIO%d, %lu baud, total raw bytes=%lu. "
      "Vehicle wiring expects GPS TX on GPIO20.\n",
      g_gpsRxPin,
      (unsigned long)g_gpsBaud,
      (unsigned long)g_gpsUartByteCount
    );
  }
}

bool waitForGpsDateTime(uint32_t timeoutMs)
{
  if (gpsDateTimeValid()) {
    return true;
  }

  Serial.println("Waiting for valid GPS UTC date/time before creating CSV...");

  uint32_t startMs = millis();
  uint32_t lastToggleMs = 0;
  uint32_t lastStatusMs = 0;
  bool ledState = false;

  while (millis() - startMs < timeoutMs) {
    serviceGps();

    if (gpsDateTimeValid()) {
      setLed(false);
      Serial.printf(
        "GPS UTC time acquired: %04u-%02u-%02u %02u:%02u:%02u.%02u\n",
        gps.date.year(),
        gps.date.month(),
        gps.date.day(),
        gps.time.hour(),
        gps.time.minute(),
        gps.time.second(),
        gps.time.centisecond()
      );
      return true;
    }

    uint32_t now = millis();

    if (now - lastToggleMs >= 250) {
      lastToggleMs = now;
      ledState = !ledState;
      setLed(ledState);
    }

    if (now - lastStatusMs >= 2000) {
      lastStatusMs = now;
      Serial.printf(
        "GPS waiting: chars=%lu, sats=%lu, dateValid=%u, timeValid=%u\n",
        (unsigned long)gps.charsProcessed(),
        (unsigned long)(gps.satellites.isValid() ? gps.satellites.value() : 0),
        gps.date.isValid() ? 1 : 0,
        gps.time.isValid() ? 1 : 0
      );
    }

    delay(10);
  }

  setLed(false);
  Serial.println("GPS UTC date/time was not acquired.");
  return false;
}

void fillGpsFields(TelemetryRecord_t &rec)
{
  rec.gps_location_valid = gps.location.isValid() ? 1 : 0;

  rec.gps_lat_e7 = rec.gps_location_valid
                     ? (int32_t)lround(gps.location.lat() * 10000000.0)
                     : 0;
  rec.gps_long_e7 = rec.gps_location_valid
                      ? (int32_t)lround(gps.location.lng() * 10000000.0)
                      : 0;

  rec.gps_alt_cm = gps.altitude.isValid()
                     ? (int32_t)lround(gps.altitude.meters() * 100.0)
                     : 0;
  rec.gps_speed_kmph_x100 = gps.speed.isValid()
                              ? (uint16_t)lround(gps.speed.kmph() * 100.0)
                              : 0;
  rec.gps_hdop_x100 = gps.hdop.isValid()
                        ? (uint16_t)gps.hdop.value()
                        : 0;
  rec.gps_sats = gps.satellites.isValid()
                   ? (uint8_t)gps.satellites.value()
                   : 0;

  rec.gps_time_valid = gps.time.isValid() ? 1 : 0;

  if (rec.gps_time_valid) {
    rec.gps_hour = gps.time.hour();
    rec.gps_minute = gps.time.minute();
    rec.gps_second = gps.time.second();
    rec.gps_centisecond = gps.time.centisecond();
  } else {
    rec.gps_hour = 0;
    rec.gps_minute = 0;
    rec.gps_second = 0;
    rec.gps_centisecond = 0;
  }
}

// =========================
// LED helpers
// =========================
void setLed(bool on)
{
  digitalWrite(LED_PIN, on ? HIGH : LOW);
}

void updateLoggingLed()
{
  setLed(g_loggingEnabled);
}

void blinkLedFor(uint32_t durationMs, uint32_t intervalMs = 250)
{
  uint32_t startMs = millis();
  uint32_t lastToggleMs = 0;
  bool ledState = false;

  while (millis() - startMs < durationMs) {
    serviceGps();

    uint32_t now = millis();
    if (now - lastToggleMs >= intervalMs) {
      lastToggleMs = now;
      ledState = !ledState;
      setLed(ledState);
    }

    delay(10);
  }

  setLed(false);
}

void waitWhileServicingGps(uint32_t durationMs)
{
  uint32_t startMs = millis();

  while (millis() - startMs < durationMs) {
    serviceGps();
    delay(10);
  }
}

void fatalFault(uint8_t flashCount, const char *message)
{
  g_loggingEnabled = false;
  setLed(false);

  Serial.printf(
    "FATAL fault %u: %s\n",
    flashCount,
    message != nullptr ? message : "unknown"
  );

  // Repeat the numbered pattern forever: 200 ms ON, 200 ms OFF for each
  // count, then a 1.5 second pause before the next group.
  while (true) {
    for (uint8_t flash = 0; flash < flashCount; flash++) {
      setLed(true);
      waitWhileServicingGps(200);
      setLed(false);
      waitWhileServicingGps(200);
    }

    waitWhileServicingGps(1500);
  }
}

// =========================
// I2C helpers
// =========================
bool i2cWrite8(uint8_t devAddr, uint8_t regAddr, uint8_t value)
{
  Wire.beginTransmission(devAddr);
  Wire.write(regAddr);
  Wire.write(value);
  return Wire.endTransmission() == 0;
}

bool i2cWrite16BE(uint8_t devAddr, uint8_t regAddr, uint16_t value)
{
  Wire.beginTransmission(devAddr);
  Wire.write(regAddr);
  Wire.write((uint8_t)((value >> 8) & 0xFF));
  Wire.write((uint8_t)(value & 0xFF));
  return Wire.endTransmission() == 0;
}

bool i2cReadBytes(uint8_t devAddr, uint8_t regAddr, uint8_t *buf, size_t len)
{
  Wire.beginTransmission(devAddr);
  Wire.write(regAddr);

  if (Wire.endTransmission(false) != 0) {
    return false;
  }

  size_t received = Wire.requestFrom((int)devAddr, (int)len);
  if (received != len) {
    return false;
  }

  for (size_t i = 0; i < len; i++) {
    buf[i] = Wire.read();
  }

  return true;
}

// =========================
// ADS1115 helpers
// =========================
bool adc16Init()
{
  Wire.beginTransmission(ADS1115_ADDR);
  return Wire.endTransmission() == 0;
}

bool ads1115ReadRaw(uint16_t configWord, int16_t &raw)
{
  if (!i2cWrite16BE(ADS1115_ADDR, ADS1115_REG_CONFIG, configWord)) {
    return false;
  }

  delay(ADS1115_CONVERSION_WAIT_MS);
  serviceGps();

  uint8_t rx[2];
  if (!i2cReadBytes(ADS1115_ADDR, ADS1115_REG_CONVERSION, rx, 2)) {
    return false;
  }

  raw = (int16_t)((rx[0] << 8) | rx[1]);
  return true;
}

bool adc16ReadCurrent(float &currentA, int16_t &rawOut)
{
  int16_t raw;
  if (!ads1115ReadRaw(ADS1115_CONFIG_WORD_AIN0, raw)) {
    return false;
  }

  float adcVoltage = (float)raw * ADS1115_LSB_VOLTS;
  float sensorVoltage = adcVoltage / ADC_DIVIDER_RATIO;

  float measuredCurrentA =
    (sensorVoltage - ADC_ZERO_CURRENT_V) / ADC_SENSITIVITY;
  currentA = CURRENT_CAL_SLOPE * measuredCurrentA + CURRENT_CAL_INTERCEPT;
  rawOut = raw;
  return true;
}

bool adc16ReadVoltage(float &voltageV)
{
  int16_t raw;
  if (!ads1115ReadRaw(ADS1115_CONFIG_WORD_AIN1, raw)) {
    return false;
  }

  float adcVoltage = (float)raw * ADS1115_LSB_VOLTS;
  voltageV = adcVoltage * VOLTAGE_INPUT_SCALE;
  return true;
}

bool adc16ReadAverageCurrent(float &avgCurrentA, float &avgVoltageV, int16_t &avgRaw)
{
  float currentSum = 0.0f;
  float voltageSum = 0.0f;
  int32_t rawSum = 0;
  uint16_t validSamples = 0;

  for (uint16_t i = 0; i < CURRENT_NUM_SAMPLES; i++) {
    float currentA;
    float voltageV;
    int16_t raw;

    if (adc16ReadCurrent(currentA, raw) &&
        adc16ReadVoltage(voltageV)) {
      currentSum += currentA;
      voltageSum += voltageV;
      rawSum += raw;
      validSamples++;
    }

    serviceGps();
  }

  if (validSamples == 0) {
    return false;
  }

  avgCurrentA = currentSum / validSamples;
  avgVoltageV = voltageSum / validSamples;
  avgRaw = (int16_t)(rawSum / validSamples);
  return true;
}

// =========================
// Thermistor helpers
// =========================
bool readThermistorVoltage(float &voltageV)
{
  int16_t raw;
  if (!ads1115ReadRaw(ADS1115_CONFIG_WORD_AIN2, raw)) {
    return false;
  }

  voltageV = ((float)raw * ADS1115_LSB_VOLTS) - g_thermistorAdcOffsetV;
  return true;
}

bool readThermistorTemperature(float &temperatureC)
{
  float voltageV;
  if (!readThermistorVoltage(voltageV)) {
    return false;
  }

  // Open/short/I2C sanity checks.
  if (voltageV >= 3.25f || voltageV <= 0.10f) {
    return false;
  }

  float thermistorResistance =
    (voltageV * THERMISTOR_SERIES_R_OHMS) /
    (THERMISTOR_SUPPLY_V - voltageV);

  if (thermistorResistance <= 0.0f) {
    return false;
  }

  float inverseTemperature =
    logf(thermistorResistance / THERMISTOR_NOMINAL_R_OHMS) /
    THERMISTOR_B_COEFFICIENT;

  inverseTemperature +=
    1.0f / (THERMISTOR_NOMINAL_TEMP_C + 273.15f);

  temperatureC = (1.0f / inverseTemperature) - 273.15f;
  return isfinite(temperatureC);
}

void calibrateThermistorAdcOffset()
{
  Serial.println("Thermistor ADC offset calibration:");
  Serial.println("Ground ADS1115 AIN2, then leave it grounded while samples are collected.");

  double sumV = 0.0;
  uint16_t validSamples = 0;

  for (uint16_t i = 0; i < THERMISTOR_OFFSET_CAL_SAMPLES; i++) {
    int16_t raw;

    if (ads1115ReadRaw(ADS1115_CONFIG_WORD_AIN2, raw)) {
      sumV += (double)raw * ADS1115_LSB_VOLTS;
      validSamples++;
    }

    delay(5);
  }

  if (validSamples == 0) {
    Serial.println("Thermistor ADC offset calibration failed: no valid samples.");
    return;
  }

  g_thermistorAdcOffsetV = (float)(sumV / validSamples);

  Serial.printf(
    "Thermistor ADC offset = %.6f V. Copy this value into THERMISTOR_ADC_OFFSET_V to make it permanent.\n",
    g_thermistorAdcOffsetV
  );
}

// =========================
// MPU6050 helpers
// =========================
bool mpuInit()
{
  if (!i2cWrite8(MPU6050_ADDR, MPU6050_REG_PWR_MGMT_1, 0x00)) {
    return false;
  }

  delay(50);

  if (!i2cWrite8(MPU6050_ADDR, MPU6050_REG_ACCEL_CONFIG, 0x00)) {
    return false;
  }

  return true;
}

bool mpuReadAccel(float &ax, float &ay, float &az)
{
  uint8_t rx[6];

  if (!i2cReadBytes(MPU6050_ADDR, MPU6050_REG_ACCEL_XOUT_H, rx, 6)) {
    return false;
  }

  int16_t rawX = (int16_t)((rx[0] << 8) | rx[1]);
  int16_t rawY = (int16_t)((rx[2] << 8) | rx[3]);
  int16_t rawZ = (int16_t)((rx[4] << 8) | rx[5]);

  ax = ((float)rawX / MPU6050_ACCEL_SENS_2G) * GRAVITY_MPS2;
  ay = ((float)rawY / MPU6050_ACCEL_SENS_2G) * GRAVITY_MPS2;
  az = ((float)rawZ / MPU6050_ACCEL_SENS_2G) * GRAVITY_MPS2;
  return true;
}

// =========================
// I2C scan
// =========================
void scanI2C()
{
  Serial.println("I2C probe start");

  for (uint8_t address = 1; address < 127; address++) {
    Wire.beginTransmission(address);

    if (Wire.endTransmission() == 0) {
      Serial.printf("Found I2C device at 0x%02X\n", address);
    }
  }

  Serial.println("I2C probe done");
}

// =========================
// Current offset calibration
// =========================
bool calibrateCurrentOffset()
{
  Serial.printf(
    "Waiting %lu ms before zero-current calibration...\n",
    (unsigned long)CURRENT_ZERO_CAL_DELAY_MS
  );

  blinkLedFor(CURRENT_ZERO_CAL_DELAY_MS, 250);

  Serial.println("Calibrating current offset for 3 seconds.");
  Serial.println("Keep the current sensor at resting current.");

  uint32_t startMs = millis();
  uint32_t lastToggleMs = 0;
  bool ledState = false;

  float sumA = 0.0f;
  int32_t rawSum = 0;
  uint32_t sampleCount = 0;

  while (millis() - startMs < CURRENT_ZERO_CAL_TIME_MS) {
    serviceGps();

    uint32_t now = millis();
    if (now - lastToggleMs >= 250) {
      lastToggleMs = now;
      ledState = !ledState;
      setLed(ledState);
    }

    int16_t raw;
    float currentA;

    if (adc16ReadCurrent(currentA, raw)) {
      sumA += currentA;
      rawSum += raw;
      sampleCount++;
    }

    delay(10);
  }

  setLed(false);

  if (sampleCount == 0) {
    Serial.println("Current offset calibration failed: no valid samples.");
    return false;
  }

  g_currentOffsetA = sumA / sampleCount;

  Serial.printf(
    "Current offset = %.6f A (%ld mA), average raw=%ld, samples=%lu\n",
    g_currentOffsetA,
    (long)lroundf(g_currentOffsetA * 1000.0f),
    (long)(rawSum / (int32_t)sampleCount),
    (unsigned long)sampleCount
  );

  return true;
}

// =========================
// LittleFS binary backup
// =========================
bool appendRecordLittleFS(const TelemetryRecord_t &rec)
{
  File file = LittleFS.open(LITTLEFS_LOG_FILE, FILE_APPEND);
  if (!file) {
    return false;
  }

  size_t bytesWritten =
    file.write((const uint8_t *)&rec, sizeof(TelemetryRecord_t));

  file.close();
  return bytesWritten == sizeof(TelemetryRecord_t);
}

void dumpLittleFSLogCsv()
{
  File file = LittleFS.open(LITTLEFS_LOG_FILE, FILE_READ);

  if (!file) {
    Serial.println("No LittleFS backup log found.");
    return;
  }

  Serial.println(
    "timestamp_ms,current_mA,voltage_mV,temperature_C,temperature_valid,"
    "wheel_speed_valid,wheel_speed_kmph,wheel_rpm,wheel_spoke_count,"
    "ax_x100,ay_x100,az_x100,amag_x100,"
    "gps_location_valid,gps_lat,gps_long,gps_alt_m,gps_speed_kmph,"
    "gps_hdop,gps_sats,gps_time_valid,gps_time_utc,gps_centisecond"
  );

  TelemetryRecord_t rec;
  uint32_t count = 0;

  while (file.available() >= (int)sizeof(TelemetryRecord_t)) {
    size_t bytesRead =
      file.read((uint8_t *)&rec, sizeof(TelemetryRecord_t));

    if (bytesRead != sizeof(TelemetryRecord_t)) {
      Serial.println("Partial/corrupt LittleFS record encountered.");
      break;
    }

    Serial.printf(
      "%lu,%d,%ld,%.2f,%u,%u,%.2f,%.1f,%lu,%d,%d,%d,%u,%u,%.7f,%.7f,%.2f,%.2f,%.2f,%u,%u,%02u:%02u:%02u,%02u\n",
      (unsigned long)rec.timestamp_ms,
      rec.current_mA,
      (long)rec.voltage_mV,
      rec.temperature_c_x100 / 100.0f,
      rec.temperature_valid,
      rec.wheel_speed_valid,
      rec.wheel_speed_kmph_x100 / 100.0f,
      rec.wheel_rpm_x10 / 10.0f,
      (unsigned long)rec.wheel_spoke_count,
      rec.accel_x_mps2_x100,
      rec.accel_y_mps2_x100,
      rec.accel_z_mps2_x100,
      rec.accel_mag_mps2_x100,
      rec.gps_location_valid,
      rec.gps_lat_e7 / 10000000.0,
      rec.gps_long_e7 / 10000000.0,
      rec.gps_alt_cm / 100.0f,
      rec.gps_speed_kmph_x100 / 100.0f,
      rec.gps_hdop_x100 / 100.0f,
      rec.gps_sats,
      rec.gps_time_valid,
      rec.gps_hour,
      rec.gps_minute,
      rec.gps_second,
      rec.gps_centisecond
    );

    count++;
  }

  file.close();
  Serial.printf("LittleFS dump complete: %lu records.\n", (unsigned long)count);
}

void eraseLittleFSLog()
{
  if (!LittleFS.exists(LITTLEFS_LOG_FILE)) {
    Serial.println("No LittleFS backup log to erase.");
    return;
  }

  if (LittleFS.remove(LITTLEFS_LOG_FILE)) {
    Serial.println("LittleFS backup log erased.");
  } else {
    Serial.println("Failed to erase LittleFS backup log.");
  }
}

// =========================
// SD card helpers
// =========================
bool initSDCard()
{
  Serial.println("Initializing SD card...");

  SPI.begin(SD_SCK, SD_MISO, SD_MOSI, SD_CS);

  if (!SD.begin(SD_CS)) {
    Serial.println("SD card mount failed.");
    return false;
  }

  uint8_t cardType = SD.cardType();

  if (cardType == CARD_NONE) {
    Serial.println("No SD card attached.");
    return false;
  }

  Serial.print("SD card type: ");

  if (cardType == CARD_MMC) {
    Serial.println("MMC");
  } else if (cardType == CARD_SD) {
    Serial.println("SDSC");
  } else if (cardType == CARD_SDHC) {
    Serial.println("SDHC");
  } else {
    Serial.println("UNKNOWN");
  }

  Serial.printf(
    "SD card size: %llu MB\n",
    SD.cardSize() / (1024ULL * 1024ULL)
  );

  return true;
}

bool writeSDCsvHeader(const char *path)
{
  File file = SD.open(path, FILE_WRITE);

  if (!file) {
    Serial.printf("Failed to create %s\n", path);
    return false;
  }

  file.println(
    "timestamp_ms,current_mA,voltage_mV,temperature_C,temperature_valid,"
    "wheel_speed_valid,wheel_speed_kmph,wheel_rpm,wheel_spoke_count,"
    "ax_x100,ay_x100,az_x100,amag_x100,"
    "gps_location_valid,gps_lat,gps_long,gps_alt_m,gps_speed_kmph,"
    "gps_hdop,gps_sats,gps_time_valid,gps_time_utc,gps_centisecond"
  );

  file.close();
  return true;
}

bool makeGpsTimestampLogFilename(char *out, size_t outSize)
{
  serviceGps();

  if (!gpsDateTimeValid()) {
    return false;
  }

  snprintf(
    out,
    outSize,
    "/%04u-%02u-%02u-%02u-%02u.csv",
    gps.date.year(),
    gps.date.month(),
    gps.date.day(),
    gps.time.hour(),
    gps.time.minute()
  );

  return true;
}

bool selectNextSDLogFile()
{
  if (!g_sdReady) {
    return false;
  }

  if (!makeGpsTimestampLogFilename(g_sdLogFile, sizeof(g_sdLogFile))) {
    for (uint16_t index = 1; index <= SD_MAX_LOG_FILES; index++) {
      snprintf(
        g_sdLogFile,
        sizeof(g_sdLogFile),
        "/telemetry_%03u.csv",
        index
      );

      if (!SD.exists(g_sdLogFile)) {
        if (!writeSDCsvHeader(g_sdLogFile)) {
          return false;
        }

        g_sdLogIndex = index;
        Serial.printf(
          "GPS time unavailable; new fallback SD log file: %s\n",
          g_sdLogFile
        );
        return true;
      }
    }

    Serial.println(
      "No free fallback filename remains. Delete old telemetry_###.csv files."
    );
    return false;
  }

  if (!SD.exists(g_sdLogFile)) {
    if (!writeSDCsvHeader(g_sdLogFile)) {
      return false;
    }

    g_sdLogIndex = 0;
    Serial.printf("New SD log file: %s\n", g_sdLogFile);
    return true;
  }

  char baseName[40];
  strncpy(baseName, g_sdLogFile, sizeof(baseName));
  baseName[sizeof(baseName) - 1] = '\0';

  char *extension = strstr(baseName, ".csv");
  if (extension != nullptr) {
    *extension = '\0';
  }

  for (uint16_t index = 1; index <= SD_MAX_LOG_FILES; index++) {
    snprintf(
      g_sdLogFile,
      sizeof(g_sdLogFile),
      "%s-%03u.csv",
      baseName,
      index
    );

    if (!SD.exists(g_sdLogFile)) {
      if (!writeSDCsvHeader(g_sdLogFile)) {
        return false;
      }

      g_sdLogIndex = index;
      Serial.printf("New SD log file: %s\n", g_sdLogFile);
      return true;
    }
  }

  Serial.println("No free timestamped SD filename remains for this minute.");
  return false;
}

bool appendRecordSD(const TelemetryRecord_t &rec)
{
  if (!g_sdReady) {
    return false;
  }

  File file = SD.open(g_sdLogFile, FILE_APPEND);

  if (!file) {
    Serial.printf("Failed to open SD log file %s\n", g_sdLogFile);
    return false;
  }

  size_t bytesWritten = file.printf(
    "%lu,%d,%ld,%.2f,%u,%u,%.2f,%.1f,%lu,%d,%d,%d,%u,%u,%.7f,%.7f,%.2f,%.2f,%.2f,%u,%u,%02u:%02u:%02u,%02u\n",
    (unsigned long)rec.timestamp_ms,
    rec.current_mA,
    (long)rec.voltage_mV,
    rec.temperature_c_x100 / 100.0f,
    rec.temperature_valid,
    rec.wheel_speed_valid,
    rec.wheel_speed_kmph_x100 / 100.0f,
    rec.wheel_rpm_x10 / 10.0f,
    (unsigned long)rec.wheel_spoke_count,
    rec.accel_x_mps2_x100,
    rec.accel_y_mps2_x100,
    rec.accel_z_mps2_x100,
    rec.accel_mag_mps2_x100,
    rec.gps_location_valid,
    rec.gps_lat_e7 / 10000000.0,
    rec.gps_long_e7 / 10000000.0,
    rec.gps_alt_cm / 100.0f,
    rec.gps_speed_kmph_x100 / 100.0f,
    rec.gps_hdop_x100 / 100.0f,
    rec.gps_sats,
    rec.gps_time_valid,
    rec.gps_hour,
    rec.gps_minute,
    rec.gps_second,
    rec.gps_centisecond
  );

  file.close();
  return bytesWritten > 0;
}

// =========================
// Logging control
// =========================
void startLoggingNewFile(const char *reason)
{
  if (!g_sdReady) {
    fatalFault(2, "SD card unavailable");
  }

  if (!waitForGpsDateTime(GPS_FILENAME_WAIT_MS)) {
    Serial.println(
      "Continuing without GPS time using a telemetry_###.csv filename."
    );
  }

  if (!selectNextSDLogFile()) {
    fatalFault(7, "SD log file could not be created");
  }

  g_loggingEnabled = true;
  updateLoggingLed();

  Serial.printf(
    "%s logging STARTED -> %s\n",
    reason != nullptr ? reason : "",
    g_sdLogFile
  );
}

void printHelp()
{
  Serial.println();
  Serial.println("Commands:");
  Serial.println("  s = start logging in a new GPS-timestamped CSV");
  Serial.println("  x = stop logging");
  Serial.println("  d = stop logging and dump LittleFS backup as CSV");
  Serial.println("  e = stop logging and erase LittleFS backup");
  Serial.println("  c = calibrate thermistor ADS1115 offset; AIN2 must be grounded");
  Serial.println("  h = print help");
  Serial.println();
}

void handleSerialCommands()
{
  while (Serial.available()) {
    char command = Serial.read();

    if (command == 's') {
      if (g_loggingEnabled) {
        Serial.printf("Already logging to %s\n", g_sdLogFile);
      } else {
        startLoggingNewFile("Serial");
      }
    } else if (command == 'x') {
      g_loggingEnabled = false;
      updateLoggingLed();
      Serial.println("Logging STOPPED.");
    } else if (command == 'd') {
      g_loggingEnabled = false;
      updateLoggingLed();
      Serial.println("Logging stopped for LittleFS dump.");
      dumpLittleFSLogCsv();
    } else if (command == 'e') {
      g_loggingEnabled = false;
      updateLoggingLed();
      Serial.println("Logging stopped for LittleFS erase.");
      eraseLittleFSLog();
    } else if (command == 'c') {
      if (g_loggingEnabled) {
        Serial.println("Stop logging with 'x' before thermistor offset calibration.");
      } else {
        calibrateThermistorAdcOffset();
      }
    } else if (command == 'h') {
      printHelp();
    }
  }
}

// =========================
// Setup
// =========================
void setup()
{
#if ARDUINO_USB_CDC_ON_BOOT
  // On ESP32-C3, hardware UART0 defaults to GPIO20/GPIO21, the same pins used
  // by the GPS connector. Only start the local console when Serial is routed
  // through native USB CDC so UART0 cannot interfere with GPS reception.
  Serial.begin(115200);
#endif
  delay(1000);

  pinMode(LED_PIN, OUTPUT);
  setLed(false);

  // Start GPS detection before lengthy initialization so every candidate is
  // serviced throughout setup as well as during normal logging.
  startGpsUartCandidate(g_gpsUartCandidateIndex);

  blinkLedFor(1000, 150);

  pinMode(BUTTON_PIN, INPUT_PULLUP);
  attachInterrupt(
    digitalPinToInterrupt(BUTTON_PIN),
    buttonISR,
    FALLING
  );

  pinMode(SPEED_SENSOR_PIN, INPUT);
  BaseType_t speedTaskStarted = xTaskCreate(
    speedSensorTask,
    "speed-sensor",
    2048,
    nullptr,
    2,
    nullptr
  );

  if (speedTaskStarted != pdPASS) {
    fatalFault(8, "speed sensor task could not start");
  }

  Serial.println();
  Serial.println("ESP32-C3 TelemV2 vehicle telemetry logger");
  Serial.printf(
    "Speedometer: GPIO%d, %u spokes, %.1f inch wheel diameter, %.4f m circumference, %lu us debounce, %lu us guard\n",
    SPEED_SENSOR_PIN,
    WHEEL_SPOKES,
    WHEEL_DIAMETER_M / 0.0254f,
    WHEEL_CIRCUMFERENCE_M,
    (unsigned long)SPEED_STATE_DEBOUNCE_US,
    (unsigned long)SPEED_MIN_PULSE_INTERVAL_US
  );

  // Live telemetry is best-effort. Failure here is intentionally non-fatal so
  // the SD logger remains fully usable without the relay.
  g_liveTelemetry.begin();

  g_sdReady = initSDCard();
  if (!g_sdReady) {
    fatalFault(2, "SD card initialization failed");
  }

  Wire.begin(PIN_I2C_SDA, PIN_I2C_SCL);
  Wire.setClock(100000);
  scanI2C();

  if (!LittleFS.begin(true)) {
    fatalFault(3, "LittleFS mount failed");
  }
  Serial.println("LittleFS mounted.");

  if (!adc16Init()) {
    fatalFault(4, "ADS1115 initialization failed");
  }
  Serial.println("ADS1115 initialized.");

  if (!mpuInit()) {
    fatalFault(5, "MPU6050 initialization failed");
  }
  Serial.println("MPU6050 initialized.");

  if (!calibrateCurrentOffset()) {
    fatalFault(6, "current offset calibration failed");
  }

  printHelp();

  // Auto-start after setup. This waits for valid GPS UTC date/time.
  startLoggingNewFile("AUTO");

  Serial.println("LED ON = recording; OFF = stopped; BLINKING = initialization/GPS wait/calibration.");
}

// =========================
// Main loop
// =========================
void loop()
{
  // Always service GPS, including while logging is stopped.
  serviceGps();
  updateWheelSpeed();
  printGpsDiagnosticIfNeeded();
  handleSerialCommands();

  if (buttonEvent) {
    buttonEvent = false;

    uint32_t now = millis();

    if (now - lastButtonHandledMs > 250) {
      lastButtonHandledMs = now;

      if (g_loggingEnabled) {
        g_loggingEnabled = false;
        updateLoggingLed();
        Serial.println("Button: logging STOPPED.");
      } else {
        startLoggingNewFile("Button");
      }
    }
  }

  if (!g_loggingEnabled) {
    delay(20);
    return;
  }

  float currentA = 0.0f;
  float averageVoltageV = 0.0f;
  int16_t adcRaw = 0;

  if (!adc16ReadAverageCurrent(currentA, averageVoltageV, adcRaw)) {
    Serial.println("ADS1115 current/voltage read failed.");
    delay(50);
    return;
  }

  float temperatureC = 0.0f;
  bool temperatureValid = readThermistorTemperature(temperatureC);

  float axSum = 0.0f;
  float aySum = 0.0f;
  float azSum = 0.0f;
  uint16_t accelValidSamples = 0;

  for (uint16_t i = 0; i < MPU_NUM_SAMPLES; i++) {
    float ax;
    float ay;
    float az;

    if (mpuReadAccel(ax, ay, az)) {
      axSum += ax;
      aySum += ay;
      azSum += az;
      accelValidSamples++;
    }

    serviceGps();
    delay(MPU_SAMPLE_DELAY);
  }

  if (accelValidSamples == 0) {
    Serial.println("MPU6050 acceleration read failed.");
    delay(50);
    return;
  }

  float axAverage = axSum / accelValidSamples;
  float ayAverage = aySum / accelValidSamples;
  float azAverage = azSum / accelValidSamples;

  float accelerationMagnitude = sqrtf(
    axAverage * axAverage +
    ayAverage * ayAverage +
    azAverage * azAverage
  );

  float correctedCurrentA = currentA - g_currentOffsetA;

  TelemetryRecord_t rec = {};

  rec.timestamp_ms = millis();

  rec.current_mA = (int16_t)lroundf(correctedCurrentA * 1000.0f);
  rec.voltage_mV = (int32_t)lroundf(averageVoltageV * 1000.0f);

  rec.temperature_valid = temperatureValid ? 1 : 0;
  rec.temperature_c_x100 = temperatureValid
                             ? (int16_t)lroundf(temperatureC * 100.0f)
                             : 0;

  rec.wheel_speed_valid = g_wheelSpeedValid ? 1 : 0;
  rec.wheel_speed_kmph_x100 = g_wheelSpeedValid
                                ? (uint32_t)lroundf(g_wheelSpeedKmph * 100.0f)
                                : 0;
  rec.wheel_rpm_x10 = g_wheelSpeedValid
                        ? (uint32_t)lroundf(g_wheelRpm * 10.0f)
                        : 0;
  rec.wheel_spoke_count = g_wheelSpokeCount;

  rec.accel_x_mps2_x100 = (int16_t)lroundf(axAverage * 100.0f);
  rec.accel_y_mps2_x100 = (int16_t)lroundf(ayAverage * 100.0f);
  rec.accel_z_mps2_x100 = (int16_t)lroundf(azAverage * 100.0f);
  rec.accel_mag_mps2_x100 =
    (uint16_t)lroundf(accelerationMagnitude * 100.0f);

  fillGpsFields(rec);

  if (!appendRecordLittleFS(rec)) {
    Serial.println("WARNING: LittleFS backup write failed.");
  }

  if (appendRecordSD(rec)) {
    Serial.printf(
      "SD LOG %s t=%lu ms I=%d mA V=%ld mV Temp=%s%.2f C "
      "Wheel=%s%.2f km/h RPM=%.1f spokes=%lu "
      "Ax=%d Ay=%d Az=%d Mag=%u GPS=%u sats=%u raw=%d\n",
      g_sdLogFile,
      (unsigned long)rec.timestamp_ms,
      rec.current_mA,
      (long)rec.voltage_mV,
      rec.temperature_valid ? "" : "INVALID/",
      rec.temperature_c_x100 / 100.0f,
      rec.wheel_speed_valid ? "" : "INVALID/",
      rec.wheel_speed_kmph_x100 / 100.0f,
      rec.wheel_rpm_x10 / 10.0f,
      (unsigned long)rec.wheel_spoke_count,
      rec.accel_x_mps2_x100,
      rec.accel_y_mps2_x100,
      rec.accel_z_mps2_x100,
      rec.accel_mag_mps2_x100,
      rec.gps_location_valid,
      rec.gps_sats,
      adcRaw
    );
  } else {
    Serial.println("SD write failed.");
    fatalFault(7, "SD log write failed");
  }

  // Mirror a throttled subset of this exact SD record to the WROVER LTE relay.
  // GPS is omitted from the packet until TinyGPSPlus reports a valid fix.
  g_liveTelemetry.send(
    rec.timestamp_ms,
    rec.current_mA,
    rec.voltage_mV,
    rec.temperature_valid != 0,
    rec.temperature_c_x100,
    rec.accel_x_mps2_x100,
    rec.accel_y_mps2_x100,
    rec.accel_z_mps2_x100,
    rec.accel_mag_mps2_x100,
    rec.wheel_speed_valid != 0,
    (uint16_t)min(rec.wheel_speed_kmph_x100, (uint32_t)UINT16_MAX),
    rec.gps_location_valid != 0,
    g_gpsUartLocked,
    rec.gps_time_valid != 0,
    g_gpsRxPin == 21,
    rec.gps_sats,
    rec.gps_lat_e7,
    rec.gps_long_e7,
    g_gpsBaud,
    g_gpsUartByteCount
  );

  delay(20);
}
