UTSM-proto/utsm-telem-firmware/(commit log)

2026-06-18 Added GPS to v1 telemetry schematic with connections and footprints, but not on pcb
    [joulemeter-B_Cu.gbr, joulemeter-B_Mask.gbr, joulemeter-B_Paste.gbr, joulemeter-B_Silkscreen.gbr, joulemeter-Edge_Cuts.gbr, joulemeter-F_Cu.gbr, joulemeter-F_Mask.gbr, joulemeter-F_Paste.gbr]
2026-06-25 Initial Thermistor code using the ADS1115 to measure temperature
2026-06-25 this does not work yet. it is in progress
    [telemetry_v2_consolidated_unfinished.ino]
2026-07-04 combined speedometer and thermistor into v2 pcb
    [joulemeter-B_Cu.gbr, joulemeter-B_Mask.gbr, joulemeter-B_Paste.gbr, joulemeter-B_Silkscreen.gbr, joulemeter-Edge_Cuts.gbr, joulemeter-F_Cu.gbr, joulemeter-F_Mask.gbr, joulemeter-F_Paste.gbr]
2026-07-18 Add ESP-NOW A7670 LTE live telemetry relay (#4)
    * Add ESP-NOW LTE live telemetry relay
    * Add LTE-only dummy telemetry test mode
    * Target LTE relay at T-A7670X
    * Add A7670 modem smoke test
    * Harden A7670 modem startup test
    * Use tested A7670X power-key timing
    * Use A7670X HTTP command set
    * Probe A7670 before toggling modem power
    * Add full-path ESP-NOW dummy demo
    * Document verified LTE relay setup
2026-07-18 Consolidated GPS, Thermistor, Joulemeter and SD card stuff in v2, need speedometer code
2026-08-01 Add TelemV2 LED fault codes
2026-08-01 Debounce TelemV2 wheel sensor cycles
2026-08-05 Ship production TelemV2 GPS LTE telemetry (#7)
    Hardware-validated TelemV2 GPS UART, 1 Hz ESP-NOW/LTE telemetry, WROVER diagnostics, and packet-v2 release.
2026-08-11 Stream motor temperature over live telemetry
2026-08-11 Automate live motor temperature setup
2026-08-11 Relay car and dyno telemetry together
2026-08-11 Reuse relay HTTP service between telemetry posts
2026-08-11 Revert "Reuse relay HTTP service between telemetry posts"
    This reverts commit c09d0e870af5a162a232d9f31dae1c4dd408e40c.
    [lte_relay.ino]
2026-08-13 Calibrate live car current readings
2026-10-03 Make live telemetry endpoint reboot-stable
    [lte_relay.ino]
